JustInTheNikOfTime/Telemetry_infinity/visualizations/1_avionics_bay.png

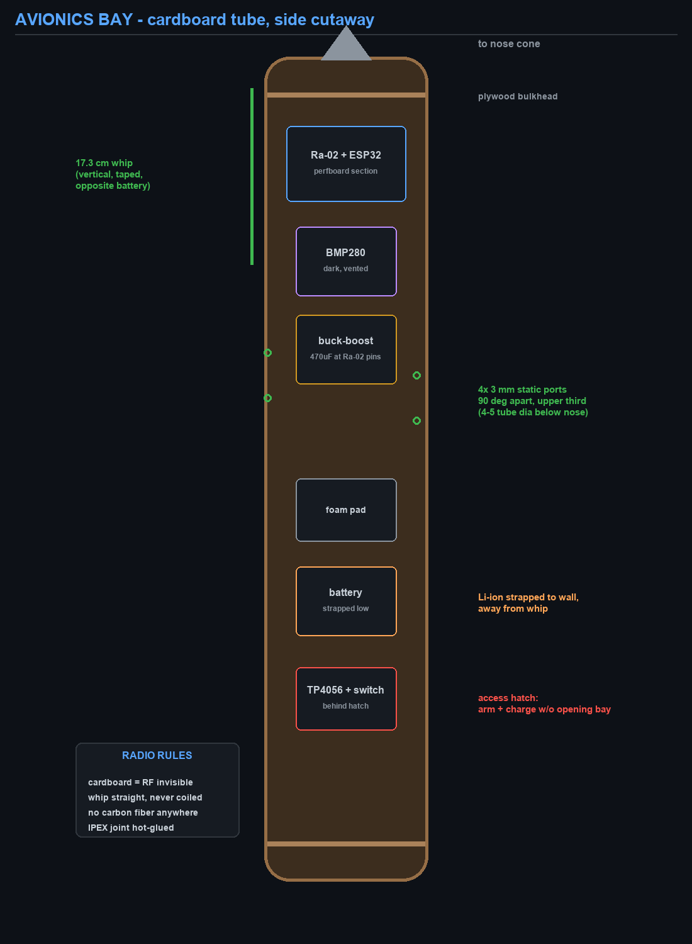
visualizations/1_avionics_bay.png
