JustInTheNikOfTime/Telemetry_infinity/visualizations/3_power_tree.png

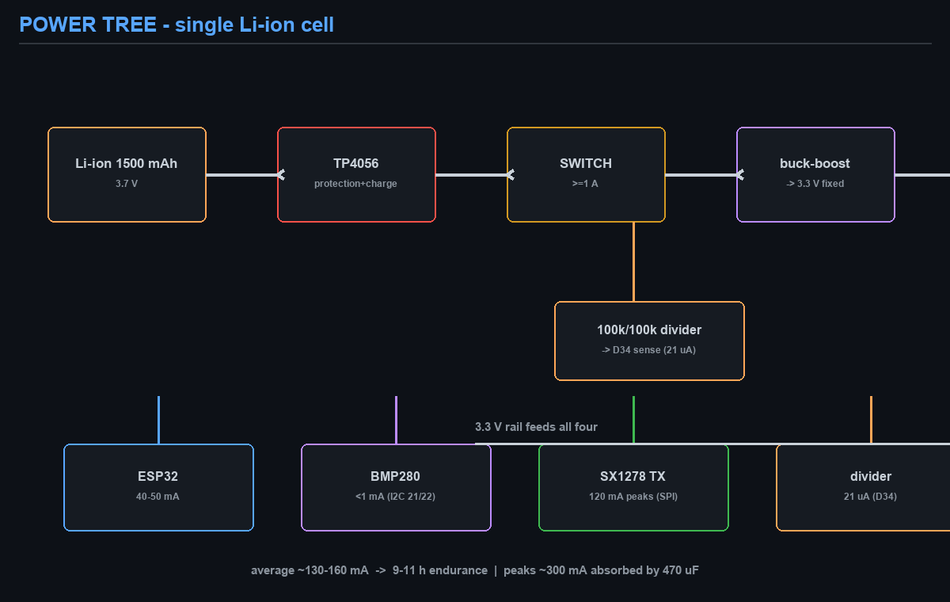
visualizations/3_power_tree.png
