JustInTheNikOfTime/Telemetry_infinity/visualizations/4_launch_checklist.png

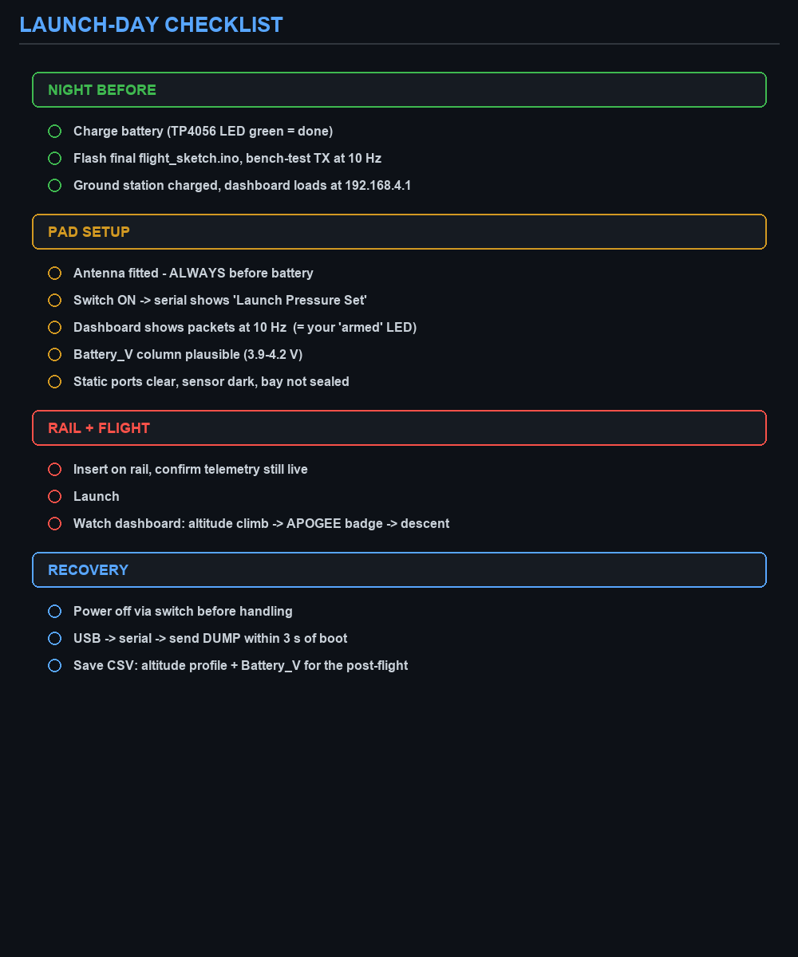
visualizations/4_launch_checklist.png
