JustInTheNikOfTime/Telemetry_infinity/visualizations/2_wiring_map.png

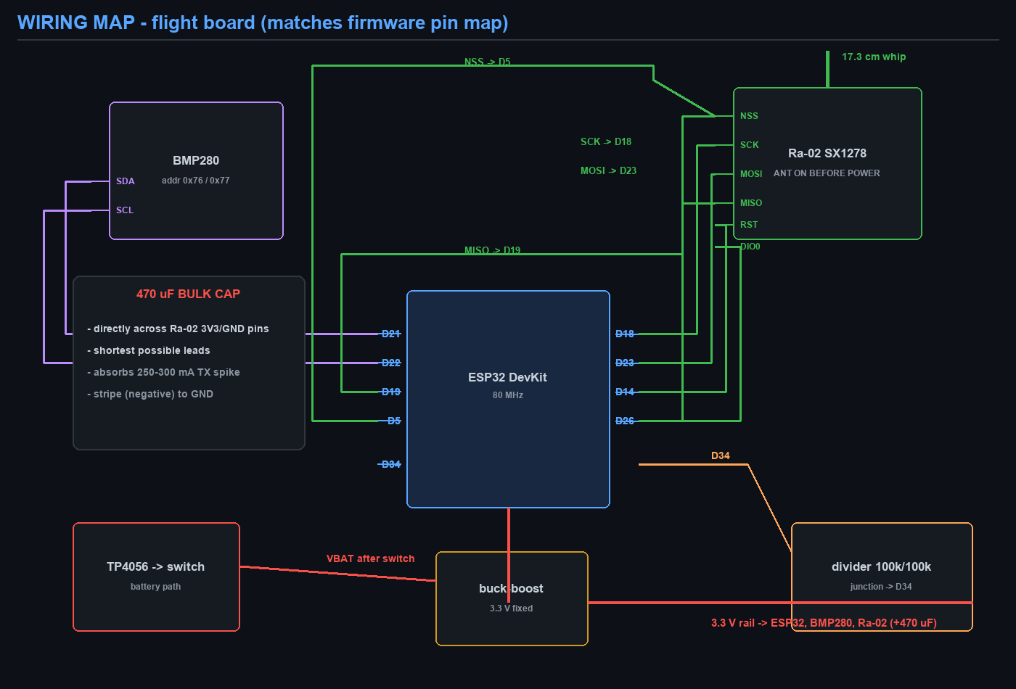
visualizations/2_wiring_map.png
